robotond/adc_matrix/README.md

# adc_matrix
read 25 temperature sensors via 10 wires
