robotond/adc_matrix/HW/acd_matrix/acd_matrix.kicad_pcb

## KiCad design HW/acd_matrix/acd_matrix.kicad_pcb (2023-06-16)

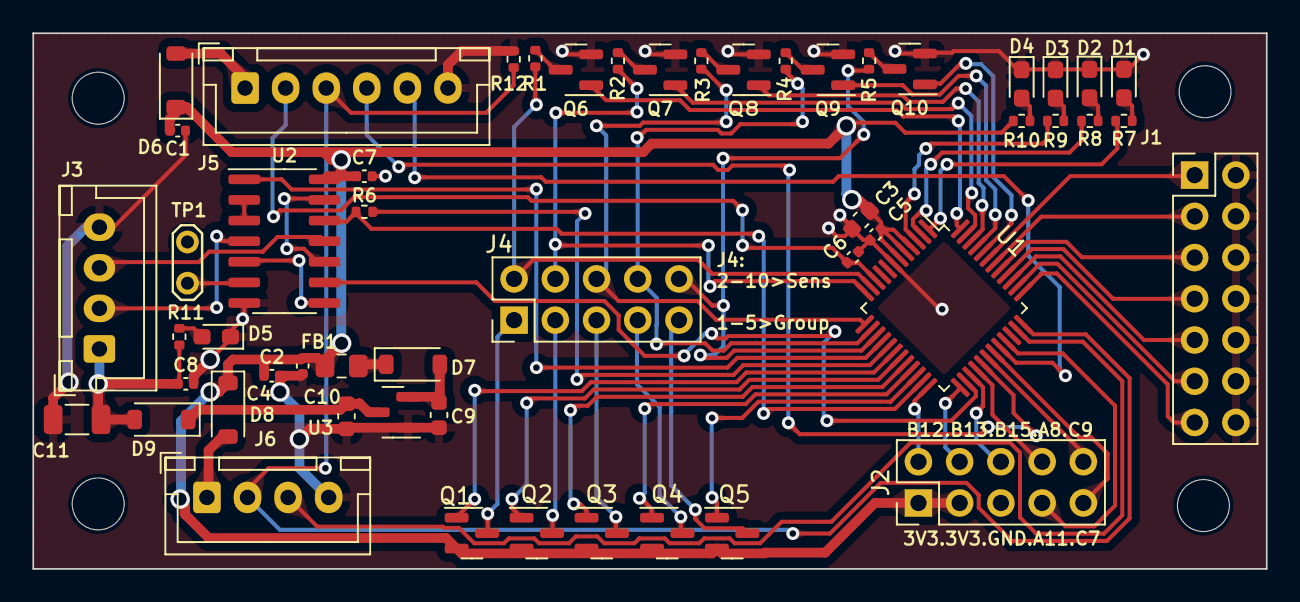
[picture p1: board acd_matrix.kicad_pcb from above]

Board: 2 copper layers, 76.0 x 33.0 mm, 57 parts (0 on the bottom side), 70 nets.

Parts:
C1, C2, C4, C5, C6, C7, C8: 100nF; C_0402_1005Metric
C3, C9, C10: 1uF; C_0603_1608Metric
C11: 22uF; C_1206_3216Metric
D1: BLUE; LED_0603_1608Metric_Pad1.05x0.95mm_HandSolder
D2: GREEN; LED_0603_1608Metric_Pad1.05x0.95mm_HandSolder
D3: RED; LED_0603_1608Metric_Pad1.05x0.95mm_HandSolder
D4: WHITE; LED_0603_1608Metric_Pad1.05x0.95mm_HandSolder
D5: YELLOW; LED_0603_1608Metric_Pad1.05x0.95mm_HandSolder
D6, D7, D8, D9: B5819W; D_SOD-123
FB1: CBM201209U601T; L_0805_2012Metric_Pad1.15x1.40mm_HandSolder
J1: EXT1; PinHeader_2x07_P2.54mm_Vertical
J2: EXT2; PinHeader_2x05_P2.54mm_Vertical
J3: NODE; JST_XH_B4B-XH-A_1x04_P2.50mm_Vertical
J4: Probe; PinHeader_2x05_P2.54mm_Vertical
J5: BOOTLDR; JST_XH_B6B-XH-A_1x06_P2.50mm_Vertical
J6: SWD; JST_XH_B4B-XH-A_1x04_P2.50mm_Vertical
Q1, Q2, Q3, Q4, Q5: Si2301; SOT-23_GSD
Q6, Q7, Q8, Q9, Q10: Si2300A; SOT-23_GSD
R1, R2, R3, R4, R5, R6: 2k4; R_0402_1005Metric
R7, R8, R9, R10, R11, R12: 4k7; R_0402_1005Metric
REF1, REF2, REF3, REF4: MountingHole_3.2mm_M3
TP1: TestPoint; TestPoint_2Pads_Pitch2.54mm_Drill0.8mm
U1: STM32G070CBTx; LQFP-48_7x7mm_P0.5mm
U2: 74LV14; SOIC-14_3.9x8.7mm_P1.27mm
U3: HXY6206I-3V3; SOT-23

Connections:
+5V: C8.1, C11.1, D9.2 (A), J3.1, R11.1
/BLUE: R7.1, U1.1 (PC13)
/COL0: Q6.1 (G), U1.48 (PB9)
/COL1: Q7.1 (G), U1.47 (PB8)
/COL2: Q8.1 (G), U1.46 (PB7)
/COL3: Q9.1 (G), U1.45 (PB6)
/COL4: Q10.1 (G), U1.44 (PB5)
/GREEN: R8.1, U1.2 (PC14)
/N0: J4.1, Q1.3 (D)
/N1: J4.3, Q2.3 (D)
/N2: J4.5, Q3.3 (D)
/N3: J4.7, Q4.3 (D)
/N4: J4.9, Q5.3 (D)
/NRST: C6.1, J5.2, U1.10 (NRST)
/PA8: J2.8, U1.28 (PA8)
/PA11: J2.7, U1.33 (PA11/PA9)
/PA15: J1.13, U1.37 (PA15)
/PB3: J1.3, U1.42 (PB3)
/PB4: J1.1, U1.43 (PB4)
/PB12: J2.2, U1.24 (PB12)
/PB13: J2.4, U1.25 (PB13)
/PB15: J2.6, U1.27 (PB15)
/PC6: J2.10, U1.30 (PC6)
/PC7: J2.9, U1.31 (PC7)
/PD0: J1.11, U1.38 (PD0)
/PD1: J1.9, U1.39 (PD1)
/PD2: J1.7, U1.40 (PD2)
/PD3: J1.5, U1.41 (PD3)
/R0: Q1.1 (G), U1.18 (PA7)
/R1: Q2.1 (G), U1.19 (PB0)
/R2: Q3.1 (G), U1.20 (PB1)
/R3: Q4.1 (G), U1.21 (PB2)
/R4: Q5.1 (G), U1.22 (PB10)
/RED: R9.1, U1.3 (PC15)
/S0: J4.2, R1.1, U1.11 (PA0)
/S1: J4.4, R2.1, U1.12 (PA1)
/S2: J4.6, R3.1, U1.13 (PA2)
/S3: J4.8, R4.1, U1.14 (PA3)
/S4: J4.10, R5.1, U1.15 (PA4)
/START: R6.1, U1.17 (PA6)
/SWCLK_BT0: J5.3, J6.2, R12.1, U1.36 (PA14)
/SWDIO: J6.3, U1.35 (PA13)
/U1RX: J5.5, U1.32 (PA10/NC)
/U1TX: J5.4, U1.29 (PA9/NC)
/U3DE: U1.26 (PB14), U2.9
/U3RX: R6.2, U1.23 (PB11), U2.12
/U3TX: U1.16 (PA5), U2.1
GND: C1.2, C2.2, C3.2, C4.2, C5.2, C6.2, C7.2, C8.2, C9.2, C10.2, C11.2, D1.1 (K), D2.1 (K), D3.1 (K), D4.1 (K), D5.1 (K), J1.2, J1.4, J1.6, J1.8, J1.10, J1.12, J1.14, J2.5, J3.4, J5.6, J6.4, Q6.2 (S), Q7.2 (S), Q8.2 (S), Q9.2 (S), Q10.2 (S), R12.2, U1.7 (VSS), U2.7 (GND), U3.1 (VSS)
unnamed: C10.1, D9.1 (K), U3.3 (VIN)
unnamed: D1.2 (A), R7.2
unnamed: D2.2 (A), R8.2
unnamed: D3.2 (A), R9.2
unnamed: D4.2 (A), R10.2
unnamed: D5.2 (A), R11.2
unnamed: D6.2 (A), J5.1
unnamed: C9.1, D7.2 (A), U3.2 (VOUT)
unnamed: D7.1 (K), FB1.2
unnamed: D8.2 (A), J6.1
unnamed: J3.2, U2.4
unnamed: J3.3, U2.11
unnamed: Q6.3 (D), R1.2
unnamed: Q7.3 (D), R2.2
unnamed: Q8.3 (D), R3.2
unnamed: Q9.3 (D), R4.2
unnamed: Q10.3 (D), R5.2
unnamed: TP1.1, U2.6
unnamed: U2.2, U2.3
unnamed: U2.5, U2.8
unnamed: U2.10, U2.13
VDD: C1.1, C2.1, C3.1, C4.1, C5.1, C7.1, D6.1 (K), D8.1 (K), FB1.1, J2.1, J2.3, Q1.2 (S), Q2.2 (S), Q3.2 (S), Q4.2 (S), Q5.2 (S), R10.1, U1.4 (VBAT), U1.5 (VREF+), U1.6 (VDD), U2.14 (3.3V)
