robotond/adc_matrix/SW/adc_matrix/Core/Src/main.c

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
/* Includes ------------------------------------------------------------------*/
#include "main.h"

/* USER CODE BEGIN Includes */
#include <stdio.h>
/* USER CODE END Includes */

/* USER CODE BEGIN PD */
#define SCOLUMNS 4
#define SROWS 4
#define MAXBUFFER 256
#define ADC_SET_TIME 1
#define RX_BUFFER_SIZE 256
#define KSMOOTH 10

/* USER CODE END PD */

ADC_HandleTypeDef hadc1;

CRC_HandleTypeDef hcrc;

UART_HandleTypeDef huart1;
UART_HandleTypeDef huart3;

/* USER CODE BEGIN PV */

uint16_t raw_temp[SROWS*SCOLUMNS];
uint16_t adc_smoothed[SROWS*SCOLUMNS];
uint16_t smooth_raw[KSMOOTH][SROWS*SCOLUMNS];
uint16_t adc_serial=0;
char tx_buffer[MAXBUFFER];
int rx_available;
char rx_buffer[RX_BUFFER_SIZE];
/* USER CODE END PV */

void SystemClock_Config(void);
static void MX_GPIO_Init(void);
static void MX_ADC1_Init(void);
static void MX_CRC_Init(void);
static void MX_USART1_UART_Init(void);
static void MX_USART3_UART_Init(void);
/* USER CODE BEGIN 0 */
void select_adc_channel(int channel)
{
    ADC_ChannelConfTypeDef sConfig = {0};
//////////    sConfig.SamplingTime = ADC_SAMPLETIME_19CYCLES_5;
    switch (channel)
    {
        case 0:
            sConfig.Channel = ADC_CHANNEL_0;
              break;
        case 1:
            sConfig.Channel = ADC_CHANNEL_1;
              break;
        case 2:
            sConfig.Channel = ADC_CHANNEL_2;
              break;
        case 3:
            sConfig.Channel = ADC_CHANNEL_3;
              break;
        case 4:
            sConfig.Channel = ADC_CHANNEL_4;
              break;
        default: sConfig.Channel = ADC_CHANNEL_TEMPSENSOR;
    }
    sConfig.Rank = ADC_REGULAR_RANK_1;
    sConfig.SamplingTime = ADC_SAMPLINGTIME_COMMON_1;
    if (HAL_ADC_ConfigChannel(&hadc1, &sConfig) != HAL_OK)
    {
      Error_Handler();
    }
}
//----------------------------------------------

//----------------------------------------------

void convert (int column,int row)
{

	select_adc_channel(column);
	HAL_GPIO_WritePin(PB4_GPIO_Port, PB4_Pin, GPIO_PIN_SET);
	HAL_ADC_Start(&hadc1);
	HAL_ADC_PollForConversion(&hadc1, HAL_MAX_DELAY);
	raw_temp[column+SCOLUMNS*row] = HAL_ADC_GetValue(&hadc1);
	HAL_GPIO_WritePin(PB4_GPIO_Port, PB4_Pin, GPIO_PIN_RESET);
	HAL_ADC_Stop(&hadc1);
}

void scan_columns(int row)
	{

		HAL_GPIO_WritePin(COL0_GPIO_Port,COL0_Pin, GPIO_PIN_SET);
		HAL_Delay(ADC_SET_TIME);
		convert(0,row);
		HAL_GPIO_WritePin(COL0_GPIO_Port,COL0_Pin, GPIO_PIN_RESET);
		HAL_Delay(1);

		HAL_GPIO_WritePin(COL1_GPIO_Port,COL1_Pin, GPIO_PIN_SET);
		HAL_Delay(ADC_SET_TIME);
		convert(1,row);
		HAL_GPIO_WritePin(COL1_GPIO_Port,COL1_Pin, GPIO_PIN_RESET);
		HAL_Delay(1);

		HAL_GPIO_WritePin(COL2_GPIO_Port,COL2_Pin, GPIO_PIN_SET);
		HAL_Delay(ADC_SET_TIME);
		convert(2,row);
		HAL_GPIO_WritePin(COL2_GPIO_Port,COL2_Pin, GPIO_PIN_RESET);
		HAL_Delay(1);

		HAL_GPIO_WritePin(COL3_GPIO_Port,COL3_Pin, GPIO_PIN_SET);
		HAL_Delay(ADC_SET_TIME);
		convert(3,row);
		HAL_GPIO_WritePin(COL3_GPIO_Port,COL3_Pin, GPIO_PIN_RESET);
		HAL_Delay(1);
/*
		HAL_GPIO_WritePin(COL4_GPIO_Port,COL4_Pin, GPIO_PIN_SET);
		HAL_Delay(5);
		convert(4,row);
		HAL_GPIO_WritePin(COL4_GPIO_Port,COL4_Pin, GPIO_PIN_RESET);
		HAL_Delay(1);
*/
	}


void scan_rows()
		{
			HAL_GPIO_WritePin(R0_GPIO_Port,R0_Pin, GPIO_PIN_RESET);
			scan_columns(0);
			HAL_GPIO_WritePin(R0_GPIO_Port,R0_Pin, GPIO_PIN_SET);

			HAL_GPIO_WritePin(R1_GPIO_Port,R1_Pin, GPIO_PIN_RESET);
			scan_columns(1);
			HAL_GPIO_WritePin(R1_GPIO_Port,R1_Pin, GPIO_PIN_SET);

			HAL_GPIO_WritePin(R2_GPIO_Port,R2_Pin, GPIO_PIN_RESET);
			scan_columns(2);
			HAL_GPIO_WritePin(R2_GPIO_Port,R2_Pin, GPIO_PIN_SET);

			HAL_GPIO_WritePin(R3_GPIO_Port,R3_Pin, GPIO_PIN_RESET);
			scan_columns(3);
			HAL_GPIO_WritePin(R3_GPIO_Port,R3_Pin, GPIO_PIN_SET);
/*
			HAL_GPIO_WritePin(R4_GPIO_Port,R4_Pin, GPIO_PIN_RESET);
			scan_columns(4);
			HAL_GPIO_WritePin(R4_GPIO_Port,R4_Pin, GPIO_PIN_SET);
*/
		}


void read_all_sensors(void)
{
	HAL_GPIO_WritePin(RED_GPIO_Port, RED_Pin, GPIO_PIN_SET);
	scan_rows();
	HAL_GPIO_WritePin(RED_GPIO_Port, RED_Pin, GPIO_PIN_RESET);
}

void read_smooth()
{
	int sum;
	for(int k=0;k<KSMOOTH;k++)
	{
		read_all_sensors();
		for(int m=0;m<SROWS*SCOLUMNS;m++) smooth_raw[k][m]=raw_temp[m];

	}
	adc_serial++;
	for(int n=0;n<SROWS*SCOLUMNS;n++)
	{
		for(int p=1;p<KSMOOTH;p++)
		{
		sum+=smooth_raw[p][n];
		}
	adc_smoothed[n]=(int)((1.0*sum)/KSMOOTH);
	}

}

void eval_comm(char comm)
{
	int s;
	s = sprintf (tx_buffer, "Received %02X\r\n",comm);
	HAL_UART_Transmit (&huart3, (uint8_t *)tx_buffer, s, 10);
	switch(comm)
	{

	}
}
/* USER CODE END 0 */

/**
  * @brief  The application entry point.
  * @retval int
  */
int main(void)
{
  /* USER CODE BEGIN 1 */
int buf_size;
  /* USER CODE END 1 */

  /* MCU Configuration--------------------------------------------------------*/

  /* Reset of all peripherals, Initializes the Flash interface and the Systick. */
  HAL_Init();

  /* Configure the system clock */
  SystemClock_Config();

  /* Initialize all configured peripherals */
  MX_GPIO_Init();
  MX_ADC1_Init();
  MX_CRC_Init();
  MX_USART1_UART_Init();
  MX_USART3_UART_Init();
  /* USER CODE BEGIN 2 */
	buf_size = sprintf (tx_buffer, "ADC matrix NTC probe \r\nBuilt on  %s at %s \r\n",__DATE__, __TIME__);
	HAL_UART_Transmit (&huart3, (uint8_t *)tx_buffer, buf_size, 10);

  /* USER CODE END 2 */

  /* Infinite loop */
  /* USER CODE BEGIN WHILE */
  while (1)
  {
//	read_all_sensors();
	  read_smooth();
	HAL_ADC_Stop(&hadc1);
//	buf_size = sprintf (tx_buffer, "%04d,%04d,%04d,%04d,%04d,%04d,%04d,%04d,%04d,%04d,%04d,%04d,%04d,%04d,%04d,%04d\r\n", raw_temp[0],raw_temp[1],raw_temp[2],raw_temp[3],raw_temp[4],raw_temp[5],raw_temp[6],raw_temp[7],raw_temp[8],raw_temp[9],raw_temp[10],raw_temp[11],raw_temp[12],raw_temp[13],raw_temp[14],raw_temp[15]);
	buf_size = sprintf (tx_buffer, "%04d\r\n", adc_smoothed[0]);
//	while (HAL_GPIO_ReadPin(START_GPIO_Port, START_Pin));
	HAL_UART_Transmit (&huart3, (uint8_t *)tx_buffer, buf_size, 10);
	HAL_Delay(200);
//	while (!HAL_GPIO_ReadPin(START_GPIO_Port, START_Pin));
/*	if(HAL_UART_Receive(&huart3,(uint8_t *)rx_buffer, 1, 1)!= HAL_OK)
		{
		__HAL_UART_CLEAR_PEFLAG(&huart3);
		__HAL_UART_CLEAR_NEFLAG(&huart3);
		__HAL_UART_CLEAR_OREFLAG(&huart3);

		}
	 else eval_comm(rx_buffer[0]);
*/
    /* USER CODE END WHILE */

    /* USER CODE BEGIN 3 */
  }
  /* USER CODE END 3 */
}

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
