robotond/adc_matrix/(commit log)

2023-06-16 Schematic added PCB layout added
    [acd_matrix.kicad_pcb, acd_matrix.kicad_sch, bom.csv, designators.csv, positions.csv]
2023-06-30 Added SW folder and STM32CUBEIDE project
2023-06-30 4 ADC channels with 16 sensors working
