robotond/adc_matrix/(notices)

Notices in the files:
SW/adc_matrix/Core/Src/main.c:
Copyright (c) 2023 STMicroelectronics.
All rights reserved.
This software is licensed under terms that can be found in the LICENSE file
